altJSV/Airwick-ESP8266/(threads)

Thread 1 (2024-06-08):

mqtt.json

tretyakovsa, 2024-06-08:
Привет. Рад видеть что мои уроки используются в проектах, а файловая система Рената тоже пригодилась.
При одном из обновлений содержимое файла mqtt.json было заменено на данные файла конфигурации.
