altJSV/Airwick-ESP8266/HTTP_init.ino

void HTTP_init(void) {
  //страница сохранения настроек mqtt
  HTTP.on("/mqtt_save", handle_mqtt_save);
  HTTP.on("/set_lightTreshold", handle_set_lightTreshold);
  HTTP.on("/lowpwr", handle_lowpower);

  // --------------------Выдаем данные configJson
  HTTP.on("/config.live.json", HTTP_GET, []() {
    outData();
    HTTP.send(200, "application/json", configJson);
  });
  // -------------------Выдаем данные configSetup
  HTTP.on("/config.setup.json", HTTP_GET, []() {
    HTTP.send(200, "application/json", configSetup);
  });

  // -------------------Выдаем данные mqttconfigJson
  HTTP.on("/config.mqtt.json", HTTP_GET, []() {
    HTTP.send(200, "application/json", mqttconfigJson);
  });

  // -------------------Выдаем данные configSetup
  HTTP.on("/restart", HTTP_GET, []() {
    String restart = HTTP.arg("device");          // Получаем значение device из запроса
    if (restart == "ok") {                         // Если значение равно Ок
      HTTP.send(200, "text / plain", "Reset OK"); // Oтправляем ответ Reset OK
      ESP.restart();                                // перезагружаем модуль
    }
    else {                                        // иначе
      HTTP.send(200, "text / plain", "No Reset"); // Oтправляем ответ No Reset
    }
  });
  // Добавляем функцию Update для перезаписи прошивки по WiFi при 1М(256K SPIFFS) и выше
  httpUpdater.setup(&HTTP);
  // Запускаем HTTP сервер
  HTTP.begin();
  // Добавляем обработчик для кнопки
  HTTP.on("/motor", []() {
    // Включаем мотор на 1 секунду
    Serial.println("Кнопка нажата в веб интерфейсе");
    if (client.connected()) //Отправка в топик сообщения об уровне освещения
    {
    client.publish(statusTopic.c_str(),"Распыляем освежитель по нажатию кнопки в веб интерфейсе");
    }
    digitalWrite(motorPin, HIGH);
    delay(1000);
    digitalWrite(motorPin, LOW);

    // Возвращаем ответ на страницу
    HTTP.send(200, "text/plain", "Motor started for 1 second");
  });
}
