altJSV/Airwick-ESP8266/(commit log)

2023-08-29 Первый релиз
2023-08-29 Добавлен график освещения
2023-08-30 Для главной страницы изменен источник данных
2023-08-30 Добавлены настройки mqtt топиков
2023-08-30 Убрана информация об освещении в status топике
2023-08-30 Изменены команды управления mqtt. Добавлена настройка порога освещения для включения таймеров
2023-08-31 Небольшие правки веб интерфейса
2023-08-31 Новые топики mqtt
2023-08-31 Добавлены настройки энергосберегающего режима
2023-08-31 Добавлен режим низкого энергопотребления
2023-08-31 Добавлены необходимые библиотеки для компилляции
2023-08-31 Добавлена схема подключения
2023-08-31 Добавлено описание проекта
2023-08-31 Обновлена справочная информация
2023-08-31 Дополнена справочная информация
2023-08-31 Небольшие правки параметров SSDP
